chcbaram/wiznet-iot-speaker/software/wiz-iot-gui/README.md

# wiz-iot-gui

## 개요 
- WIZ-IOT-SPEAKER  GUI 프로그램 

## 개발환경
- python3
- PySide6 6.5.0
- scipy

## 설치하기
- 패키지 설치
  ```
  pip install -r requirements.txt

  ```
- 실행하기
  ```
  python wiz-iot-gui.py
  or
  python3 wiz-iot-gui.py
  ```
