chcbaram/wiznet-iot-speaker/hardware/io_bd/BOM_PCB_IOT-SPEAKER-IO_2023-04-30.csv

ID | Name | Designator | Footprint | Quantity | Manufacturer Part | Manufacturer | Supplier | Supplier Part | Price | Pins | 3DModel | Contributor | Resistance (Ohms) | link
1 | 0Ω | R1,R39 | R0402 | 2 | 0402WGF0000TCE | UNI-ROYAL(厚声) | LCSC | C17168 |  | 2 | KNOB-CHROME-20 | lcsc | 0 | https://item.szlcsc.com/323315.html
2 | 240X240 ST7789 TFT SPI DISPLAY | U4 | 240X240 1.3 TFT SPI DISPLAY | 1 |  |  |  |  |  | 7 | User Library-1_3 TFT IPS - Module | bryan_6020 |  | https://www.aliexpress.com/item/1005001511580368.html
3 | 0Ω | R2 | R0402 | 1 | 0402WGF0000TCE | UNI-ROYAL(厚声) | LCSC | C17168 |  | 2 | cube2x2m | lcsc | 0 | https://item.szlcsc.com/323315.html
4 | 0.1u | C1,C2,C3,C4 | C0603 | 4 |  |  |  |  |  | 2 | C0603_L1.6-W0.8-H0.8 | LCEDA_Lib |  | https://item.szlcsc.com/362304.html
5 | 10k | R3,R4,R5,R6,R7,R8 | R0603 | 6 |  |  |  |  |  | 2 | R0603 | LCEDA_Lib |  | https://www.mouser.in/datasheet/2/447/PYu_RT_1_to_0_01_RoHS_L_11-1669912.pdf
6 | ROTARY-ENCODER | U1,U2 | ROTATY-ENCODER | 2 |  |  |  |  |  | 7 | Rotary encoder | sakdnx
7 | FH-00094 | H2 | HDR-TH_30P-P2.54-V-F-R2-C15-S2.54 | 1 | FH-00094 | Liansheng(连盛) | LCSC | C2829904 | 0.043 | 30 | HDR2.54-F-LI-2X15P | LCSC |  | https://item.szlcsc.com/59416.html
