chcbaram/wiznet-iot-speaker/hardware/main_bd/BOM_PCB_IOT-SPEAKER_2023-04-30.csv

ID | Name | Designator | Footprint | Quantity | Manufacturer Part | Manufacturer | Supplier | Supplier Part | Price | Pins | 3DModel | Contributor | Frequency | Resistance | Resistance (Ohms) | link
1 | 100nF | C55,C57,C37,C43,C44,C45,C46,C47,C48,C49,C50,C51,C52,C53,C36,C16,C17,C18,C19,C20,C21,C23,C24,C25,C26,C27,C28,C29,C30,C31,C33,C34,C22,C11,C13 | C0402 | 35 | CL05B104KB54PNC | Samsung Electro-Mechanics | LCSC | C307331 | 0.001 | 2 | C0402_L1.0-W0.5-H0.5 | LCSC |  |  |  | https://item.szlcsc.com/15869.html
2 | 100nF | C56 | C0603 | 1 | C1608X7R104KGTS | DARFON(达方) | LCSC | C335111 |  | 2 | C0603_L1.6-W0.8-H0.8 | LCSC |  |  |  | https://item.szlcsc.com/362304.html
3 | 10kΩ | R45,R46,R41,R15,R36,R37,R7 | R0402 | 7 | 0402WGF1002TCE | UniOhm | LCSC | C25744 |  | 2 | R0402_L1.0-W0.5-H0.5 | lcsc |  |  | 10K | https://item.szlcsc.com/323315.html
4 | 74LVC1G125GW,125 | U8 | SOT-353_L2.1-W1.3-P0.65-LS2.3-BR | 1 | 74LVC1G125GW,125 | Nexperia(安世) | LCSC | C12519 | 0.014 | 5 | SOT-353-5P_L2.0-W1.3-H1.1-LS2.0-P0.65 | lcsc |  |  |  | https://item.szlcsc.com/421835.html
5 | 74LVC1G126GW,125 | U9 | SOT-353_L2.2-W1.4-P0.65-LS2.4-BR | 1 | 74LVC1G126GW,125 | Nexperia(安世) | LCSC | C55052 | 0.012 | 5 | SOT-353-5P_L2.0-W1.3-H1.1-LS2.0-P0.65 | lcsc |  |  |  | https://item.szlcsc.com/330720.html
6 | 2.2uF | C38,C40,C39 | C0402 | 3 | CL05A225MQ5NSNC | SAMSUNG(三星) | LCSC | C12530 |  | 2 | C0402_L1.0-W0.5-H0.5 | lcsc |  |  |  | https://item.szlcsc.com/15869.html
7 | 1uF | C41,C42,C2,C32,C7,C8,C9,C10 | C0402 | 8 | CL05A105KA5NQNC | SAMSUNG | LCSC | C52923 | 0.001 | 2 | C0402_L1.0-W0.5-H0.5 | lcsc |  |  |  | https://item.szlcsc.com/15869.html
8 | 0Ω | R39,R40,R26,R27 | R0402 | 4 | 0402WGF0000TCE | UNI-ROYAL(厚声) | LCSC | C17168 |  | 2 | R0402_L1.0-W0.5-H0.5 | lcsc |  |  | 0 | https://item.szlcsc.com/323315.html
9 | S3B-EH(LF)(SN) | CN1 | CONN-TH_3P-P2.50_S3B-EH-LF-SN | 1 | S3B-EH(LF)(SN) | JST Sales America | LCSC | C263754 | 0.008 | 3 | CONN-TH_3P-P2.50_S3B-EH-LF-SN | LCSC |  |  |  | https://lcsc.com/product-detail/Wire-To-Board-Wire-To-Wire-Connector_JST-Sales-America_S3B-EH-LF-SN_JST-Sales-America-S3B-EH-LF-SN_C263754.html
10 | 10uF | C35,C5 | C1206 | 2 | CL31A106KBHNNNE | SAMSUNG | LCSC | C13585 | 0.005 | 2 | C1206_L3.2-W1.6-H1.3 | lcsc |  |  |  | https://item.szlcsc.com/89171.html
11 | NSR0320MW2T1G | D2,D3 | SOD-323_L1.8-W1.3-LS2.5-RD | 2 | NSR0320MW2T1G | ON | LCSC | C48192 | 0.01 | 2 | SOD-323_L1.7-W1.3-H1.1-LS2.5 | lcsc |  |  |  | https://item.szlcsc.com/295156.html
12 | 100K | R12 | R0402 | 1 | AC0402JR-07100KL | YAGEO | LCSC | C144732 |  | 2 | R0402_L1.0-W0.5-H0.5 | LCSC |  | 100kΩ |  | https://item.szlcsc.com/323315.html
13 | XC6210B332MR_C424705 | U3 | SOT-25_L3.0-W1.6-P0.95-LS2.8-BL | 1 | XC6210B332MR | Torex Semicon | LCSC | C424705 | 0.054 | 5 | SOT-25-5_L3.0-W1.6-H1.3-LS2.8-P0.95 | LCSC |  |  |  | https://item.szlcsc.com/464949.html
14 | 5.1kΩ | R31,R32,R14,R23,R25,R1,R2 | R0402 | 7 | 0402WGF5101TCE | UniOhm | LCSC | C25905 |  | 2 | R0402_L1.0-W0.5-H0.5 | lcsc |  |  | 5.1K | https://item.szlcsc.com/323315.html
15 | 53261-0471 | CN4,CN5 | CONN-SMD_4P-P1.25_53261-0471 | 2 | 53261-0471 | MOLEX | LCSC | C240847 | 0.02 | 6 | CONN-SMD_MX1.25-WS-4P | LCSC |  |  |  | https://list.szlcsc.com/catalog/11068.html
16 | 1N5819WS | D4 | SOD-323_L1.8-W1.3-LS2.5-RD | 1 | 1N5819WS | Hottech(合科泰) | LCSC | C191023 | 0.002 | 2 | SOD-323_L1.7-W1.3-H1.1-LS2.5 | LCSC |  |  |  | https://item.szlcsc.com/295156.html
17 | MMBT2222A_C8512 | Q1 | SOT-23-3_L2.9-W1.3-P1.90-LS2.4-BR | 1 | MMBT2222A 1P | CJ(江苏长电/长晶) | LCSC | C8512 | 0.003 | 3 | SOT-23-3P_L2.9-W1.3-H1.0-LS2.4-P0.95 | lcsc |  |  |  | https://www.diodes.com/assets/Package-Files/SOT23.pdf
18 | 1kΩ | R33 | R0402 | 1 | 0402WGF1001TCE | UniOhm | LCSC | C11702 |  | 2 | R0402_L1.0-W0.5-H0.5 | lcsc |  |  | 1K | https://item.szlcsc.com/323315.html
19 | 470Ω | R34,R35,R38 | R0402 | 3 | 0402WGF4700TCE | UniOhm | LCSC | C25117 |  | 2 | R0402_L1.0-W0.5-H0.5 | lcsc |  |  | 470 | https://item.szlcsc.com/323315.html
20 | Y2C-CQ2R2L-YELLOW | LED5,LED1,LED6,LED7,LED8,LED3 | LED0603-RD-YELLOW | 6 | 19-213/Y2C-CQ2R2L/3T(CY) | EVERLIGHT(亿光) | LCSC | C72038 | 0.004 | 2 | LED0603-RD-YELLOW | lcsc |  |  |  | https://atta.szlcsc.com/upload/public/pdf/source/20180129/C125100_15171877314981315871.pdf
21 | 1MΩ | R3 | R0603 | 1 | 0603WAF1004T5E | UNI-ROYAL(厚声) | LCSC | C22935 |  | 2 | R0603 | lcsc |  |  | 1M | https://www.mouser.in/datasheet/2/447/PYu_RT_1_to_0_01_RoHS_L_11-1669912.pdf
22 | FST-5030 | BUZZER1 | BUZ-SMD_FST-5030 | 1 | FUET-5030 | FUET(福声科技) | LCSC | C391031 | 0.1 | 3 | BUZ-SMD_3P-L5.0-W5.0-H3.0-P3.50 | LCSC | 4kHz |  |  | https://item.szlcsc.com/367493.html
23 | PZ254-2-15-Z-8.5 | H1 | HDR-TH_30P-P2.54-V-M-R2-C15-S2.54 | 1 | PZ254-2-15-Z-8.5 | HCTL(华灿天禄) | LCSC | C2894976 | 0.052 | 30 | HDR-TH_30P-P2.54-M-LI-2X15P | LCSC |  |  |  | https://item.szlcsc.com/57525.html
24 | 533980371 | J1 | CONN-SMD_3P-P1.25_53398-0371 | 1 | 533980371 | MOLEX | LCSC | C293633 | 0.018 | 5 | CONN-SMD_MX1.25-LS-3P | LCSC |  |  |  | https://item.szlcsc.com/278549.html
25 | 0533980271 | CN6 | CONN-SMD_2P-P1.25_053398-0X71 | 1 | 0533980271 | MOLEX | LCSC | C122410 | 0.017 | 4 | CONN-SMD_MX1.25-LS-2P | 立创EDA官方封装库 |  |  |  | https://atta.szlcsc.com/upload/public/pdf/source/20170721/C122410_1500619309943834053.pdf
26 | 533980471 | CN9 | CONN-SMD_4P-P1.25_533980471 | 1 | 533980471 | MOLEX | LCSC | C234195 | 0.02 | 6 | CONN-SMD_MX1.25-LS-4P | LCSC |  |  |  | https://item.szlcsc.com/233965.html
27 | RT7-ZZ-0117 | RJ1 | RJ45-TH_RT7-ZZ-0117 | 1 | RT7-ZZ-0117 | UDE Corp | LCSC | C711503 | 0.287 | 14 | RJ45-TH_RT7-ZZ-0117 | LCSC |  |  |  | https://item.szlcsc.com/750222.html
28 | 10uF | C1,C6 | CAP-SMD_L3.2-W1.6-RD-C7171 | 2 | TAJA106K016RNJ | Kyocera AVX | LCSC | C7171 | 0.014 | 2 | CASE-A_L3.2-W1.6-H1.6 | lcsc |  |  |  | https://item.szlcsc.com/210648.html
29 | 1nF | C15 | C1206 | 1 | 1206B102K202NT | FH(风华) | LCSC | C9196 | 0.001 | 2 | C1206_L3.2-W1.6-H1.3 | lcsc |  |  |  | https://item.szlcsc.com/89171.html
30 | 330Ω | R16,R17,R18,R19,R20,R21,R22 | R0402 | 7 | 0402WGF3300TCE | UNI-ROYAL(厚声) | LCSC | C25104 |  | 2 | R0402_L1.0-W0.5-H0.5 | lcsc |  |  | 330 | https://item.szlcsc.com/323315.html
31 | 49.9Ω | R24,R28,R29,R30 | R0402 | 4 | 0402WGF499JTCE | UNI-ROYAL(厚声) | LCSC | C25120 |  | 2 | R0402_L1.0-W0.5-H0.5 | lcsc |  |  | 49.9 | https://item.szlcsc.com/323315.html
32 | 1SS181 | D1 | SOT-23-3_L2.9-W1.6-P1.90-LS2.8-BR-CW | 1 | 1SS181 | CJ(江苏长电/长晶) | LCSC | C8550 | 0.004 | 3 | SOT-23-3L_L2.9-W1.6-H1.1-LS2.8-P0.95 | lcsc |  |  |  | https://item.szlcsc.com/14454.html
33 | GHC-YR1S2-EMERALD | LED2 | LED0603-RD | 1 | 19-217/GHC-YR1S2/3T | EVERLIGHT(亿光) | LCSC | C72043 | 0.004 | 2 | LED0603-RD | lcsc |  |  |  | https://item.szlcsc.com/347874.html
34 | XL-1608SURC-RED | LED4 | LED0603-RD_RED | 1 | XL-1608SURC-06 | XINGLIGHT(成兴光) | LCSC | C965799 | 0.001 | 2 | LED0603-RD_RED | LCSC |  |  |  | https://item.szlcsc.com/221679.html
35 | 100kΩ | R4,R5,R6,R8 | R0402 | 4 | 0402WGF1003TCE | UNI-ROYAL(厚声) | LCSC | C25741 |  | 2 | R0402_L1.0-W0.5-H0.5 | lcsc |  |  | 100K | https://item.szlcsc.com/323315.html
36 | 12kΩ 1% | R9 | R0402 | 1 | 0402WGF1202TCE | UNI-ROYAL(厚声) | LCSC | C25752 |  | 2 | R0402_L1.0-W0.5-H0.5 | lcsc |  |  | 12K | https://item.szlcsc.com/323315.html
37 | 300Ω 1% | R10 | R0402 | 1 | 0402WGF3000TCE | UNI-ROYAL(厚声) | LCSC | C25102 |  | 2 | R0402_L1.0-W0.5-H0.5 | lcsc |  |  | 300 | https://item.szlcsc.com/323315.html
38 | TYPE-C 6P(073) | USB3 | TYPE-C-SMD_TYPE-C-6P | 1 | TYPE-C 6P(073) | SHOU HAN(首韩) | LCSC | C668623 | 0.006 | 10 | TYPE-C-SMD_6P-L8.9-W6.8-H3.2-P1.00 | LCSC |  |  |  | https://item.szlcsc.com/458819.html
39 | 6.8pF | C12,C14 | C0402 | 2 | 0402CG6R8C500NT | FH(风华) | LCSC | C1576 |  | 2 | C0402_L1.0-W0.5-H0.5 | lcsc |  |  |  | https://item.szlcsc.com/15869.html
40 | 10pF | C3,C4 | C0402 | 2 | CL05C100JB5NNNC | SAMSUNG(三星) | LCSC | C32949 | 0.001 | 2 | C0402_L1.0-W0.5-H0.5 | lcsc |  |  |  | https://item.szlcsc.com/15869.html
41 | 25MHz | X2 | OSC-SMD_4P-L3.2-W2.5-BL | 1 | OT322525MJBA4SL | YXC(扬兴晶振) | LCSC | C669088 | 0.074 | 4 | OSC-SMD_4P-L3.2-W2.5-H1.0 | LCSC |  |  |  | https://item.szlcsc.com/15866.html
42 | W5300 | U1 | LQFP-100_L14.0-W14.0-P0.50-LS16.0-BL | 1 | W5300 | WIZNET | LCSC | C41156 | 1.405 | 100 | LQFP-100_L14.0-W14.0-H1.4-LS16.0-P0.50 | lcsc |  |  |  | https://item.szlcsc.com/417273.html
43 | STM32H723ZGT6 | U2 | LQFP-144_L20.0-W20.0-P0.50-LS22.0-BL | 1 | STM32H723ZGT6 | ST(意法半导体) | LCSC | C730146 | 1.813 | 144 | LQFP-144_L20.0-W20.0-P0.50-LS22.0-BL | LCSC |  |  |  | https://item.szlcsc.com/185665.html
44 | KH-TYPE-C-16P-T | USB1 | USB-C-SMD_KH-TYPE-C-16P | 1 | KH-TYPE-C-16P-T | Shenzhen Kinghelm Elec | LCSC | C709358 | 0.017 | 20 | USB-C_SMD-TYPE-C-31-M-12 | LCSC |  |  |  | https://item.szlcsc.com/747093.html
45 | TF-015 | CARD2 | TF-SMD_TF-015 | 1 | TF-015 | SOFNG | LCSC | C113206 | 0.031 | 13 | TF-SMD_L14.8-W14.5-H1.9-P1.1 | 立创EDA官方封装库 |  |  |  | https://atta.szlcsc.com/upload/public/pdf/source/20201230/C410351_87BE98C0247012AA7FFCC5A0490FF8D3.pdf
46 | IDC_DC3-14P 2X7P双排直针插座 | CN3 | IDC-TH_14P-P1.27_C9900022506 | 1 | IDC_DC3-14P 2X7P双排直针插座 | null | LCSC | C9900022506 |  | 14 | IDC-TH_14P-P1.27_C9900022506 | lcsc |  |  |  | https://img.jlc.com/pdf/applyPasteComponent/2022-06-24/582943A/d1dec1e882ce4563bda310dbdf5641bd/IDC3-14P%E5%8F%8C%E6%8E%92%E7%9B%B4%E9%92%88%E6%8F%92%E5%BA%A7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
47 | NC | R11 | R0603 | 1 | R0603RXX104XJ10LTS | Shenzhen Eyang Tech Development | LCSC |  |  | 2 | R0603_L1.6-W0.8-H0.8 | LCSC |  |  | NC | https://www.mouser.in/datasheet/2/447/PYu_RT_1_to_0_01_RoHS_L_11-1669912.pdf
48 | MAX98357AETE+T | U5 | TQFN-16_L3.0-W3.0-P0.50-BL-EP1.5 | 1 | MAX98357AETE+T | MAXIM(美信) | LCSC | C910544 | 0.136 | 17 | TQFN-16_L3.0-W3.0-P0.50-BL-EP1.5 | LCSC |  |  |  | https://item.szlcsc.com/533528.html
49 | PJ-327C-4A | AUDIO1 | AUDIO-SMD_PJ-327C-4A | 1 | PJ-327C-4A | HRO | LCSC | C145813 | 0.019 | 4 | AUDIO-SMD_L11.8-W6.0-H5.0-4P | LCSC |  |  |  | https://item.szlcsc.com/157145.html
50 | ES8156 | U6 | QFN-20_L3.0-W3.0-P0.40-TL-EP1.7 | 1 | ES8156 | Everest-semi(顺芯) | LCSC | C2887138 | 0.086 | 21 | QFN-20_L3.0-W3.0-H0.6-P0.40-BL | LCSC |  |  |  | https://img.jlc.com//pdf/applyPasteComponent/2021-08-16/1325578A/829bd16b0cc1491bbaa694c3e8fa849f/ES8156.PDF
51 | SKRPACE010 | SW1,SW2,SW3,SW4,SW5 | KEY-SMD_4P-L4.2-W3.2-P2.20-LS4.6 | 5 | SKRPACE010 | ALPS | LCSC | C139797 | 0.007 | 4 | KEY-SMD_4P-L4.2-W3.2-H2.5-LS4.6-P2.2 | LCSC |  |  |  | https://item.szlcsc.com/157210.html
52 | 25MHz | X1 | CRYSTAL-SMD_4P-L3.2-W2.5-BL | 1 | X322525MMB4SI | YXC(扬兴晶振) | LCSC | C70582 | 0.014 | 4 | OSC-SMD_4P-L3.2-W2.5-H1.0 | lcsc |  |  |  | https://item.szlcsc.com/15866.html
53 | 32.768kHz | X3 | OSC-SMD_L3.2-W1.5 | 1 | X1A000141000600 | EPSON(爱普生) | LCSC | C94673 | 0.053 | 2 | OSC-SMD_L3.2-W1.5-H0.8 | lcsc |  |  |  | https://item.szlcsc.com/100222.html
54 | W25Q128JVSIQTR | U7 | SOIC-8_L5.3-W5.3-P1.27-LS8.0-BL | 1 | W25Q128JVSIQTR | WINBOND | LCSC | C97521 | 0.112 | 8 | SOIC-8_L5.3-W5.3-H1.9-LS7.9-P1.27 | lcsc |  |  |  | https://item.szlcsc.com/63461.html
