chcbaram/wiznet-iot-speaker/hardware/io_bd/Schematic_IOT-SPEAKER-IO_2023-04-30.pdf

## 1.3" IPS 240x240 SPI

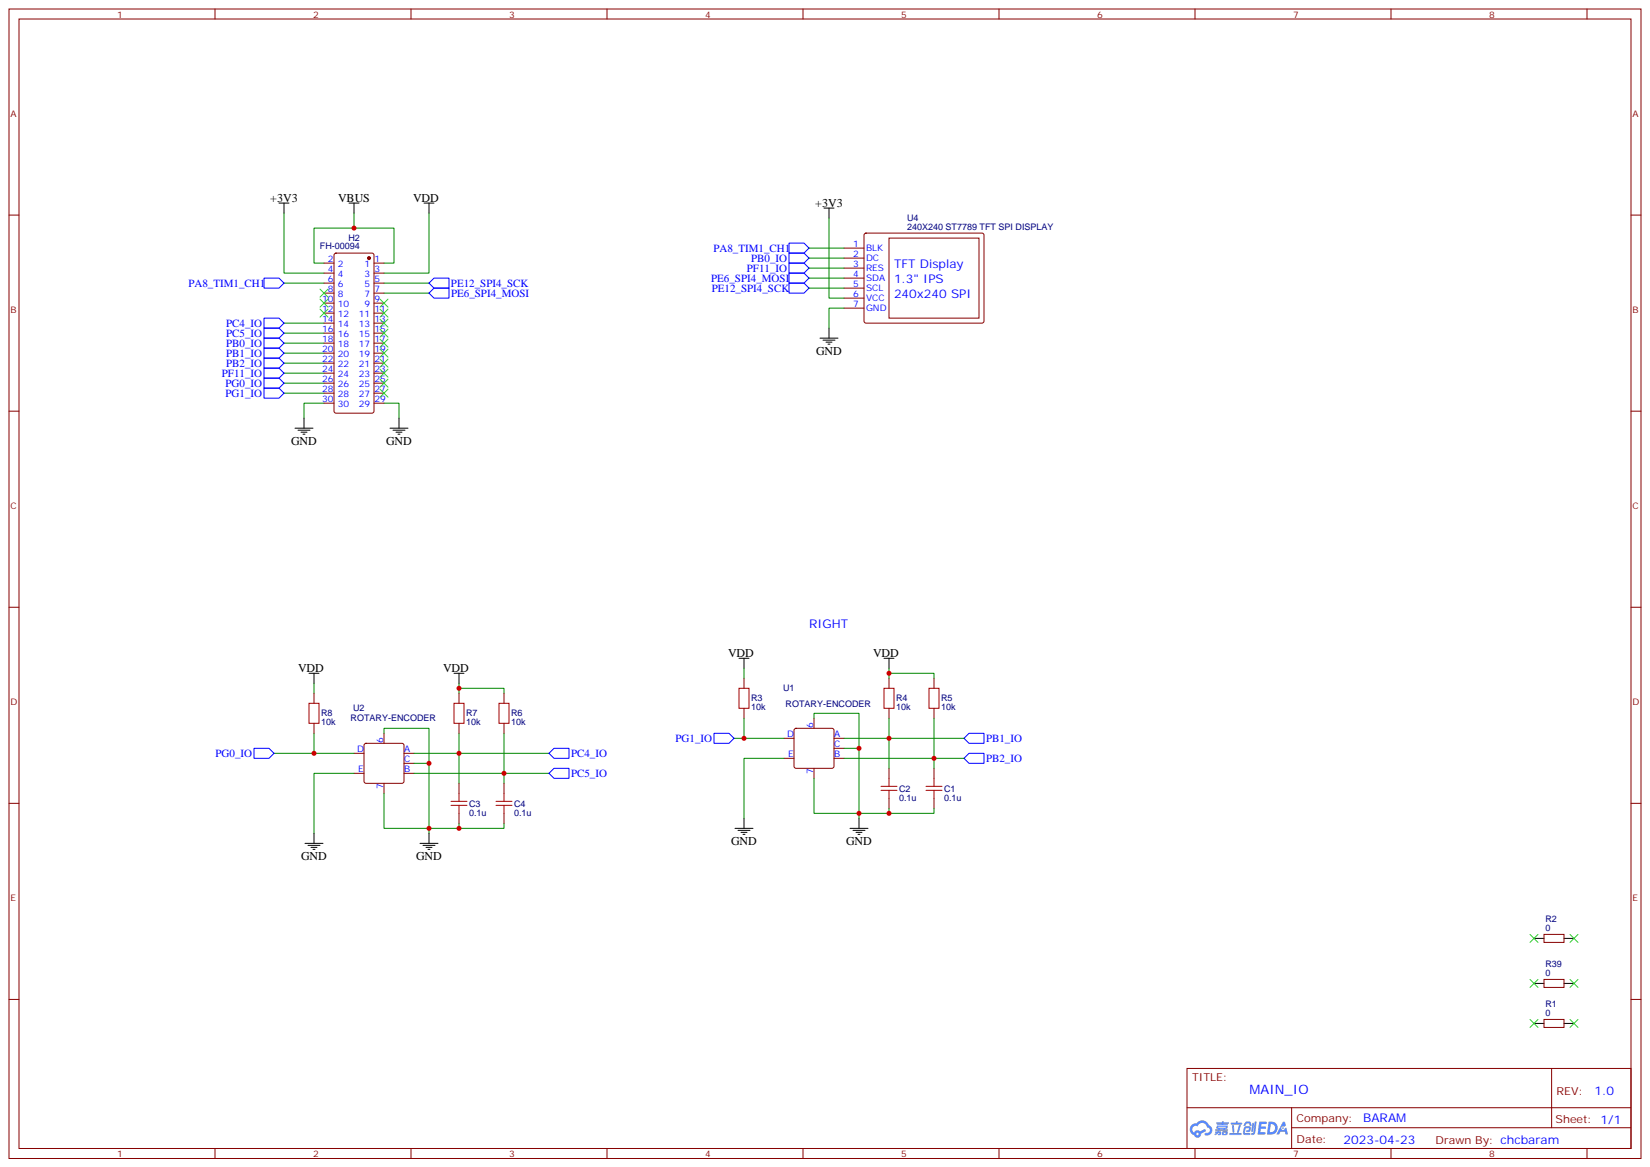
[picture p1: page 1]
