chcbaram/wiznet-iot-speaker/hardware/main_bd/Schematic_IOT-SPEAKER_2023-04-30.pdf

VDD 72 PB12 73 PB13 74 PB14 75 PB15 76 PD8 77 PD9 78 PD10 79 PD11 80 PD12 81 PD13 82 VSS 83 VDD 84 PD14 85 PD15 86 PG2 87 PG3 88 PG4 89 PG5 90 PG6 91 PG7 92 PG8 93 VSS 94 VDD33USB 95 PC6 96 PC7 97 PC8 98 PC9 99 PA8 100 PA9 101 PA10 102 PA11 103 PA12 104 PA13 105 VCAP 106 VSS 107 VDD 108 PA14 109 PA15 110 PC10 111 PC11 112 PC12 113 PD0 114 PD1 115 PD2 116 PD3 117 PD4 118 PD5 119 VSS 120 VDD 121 PD6 122 PD7 123 PG9 124 PG10 125 PG11 126 PG12 127 PG13 128 PG14 129 VSS 130 VDD 131 PG15 132 PB3 133 PB4 134 PB5 135 PB6 136 PB7 137 BOOT0 138 PB8 139 PB9 140 PE0 141 PE1 142 PDR_ON 143 VDD 144

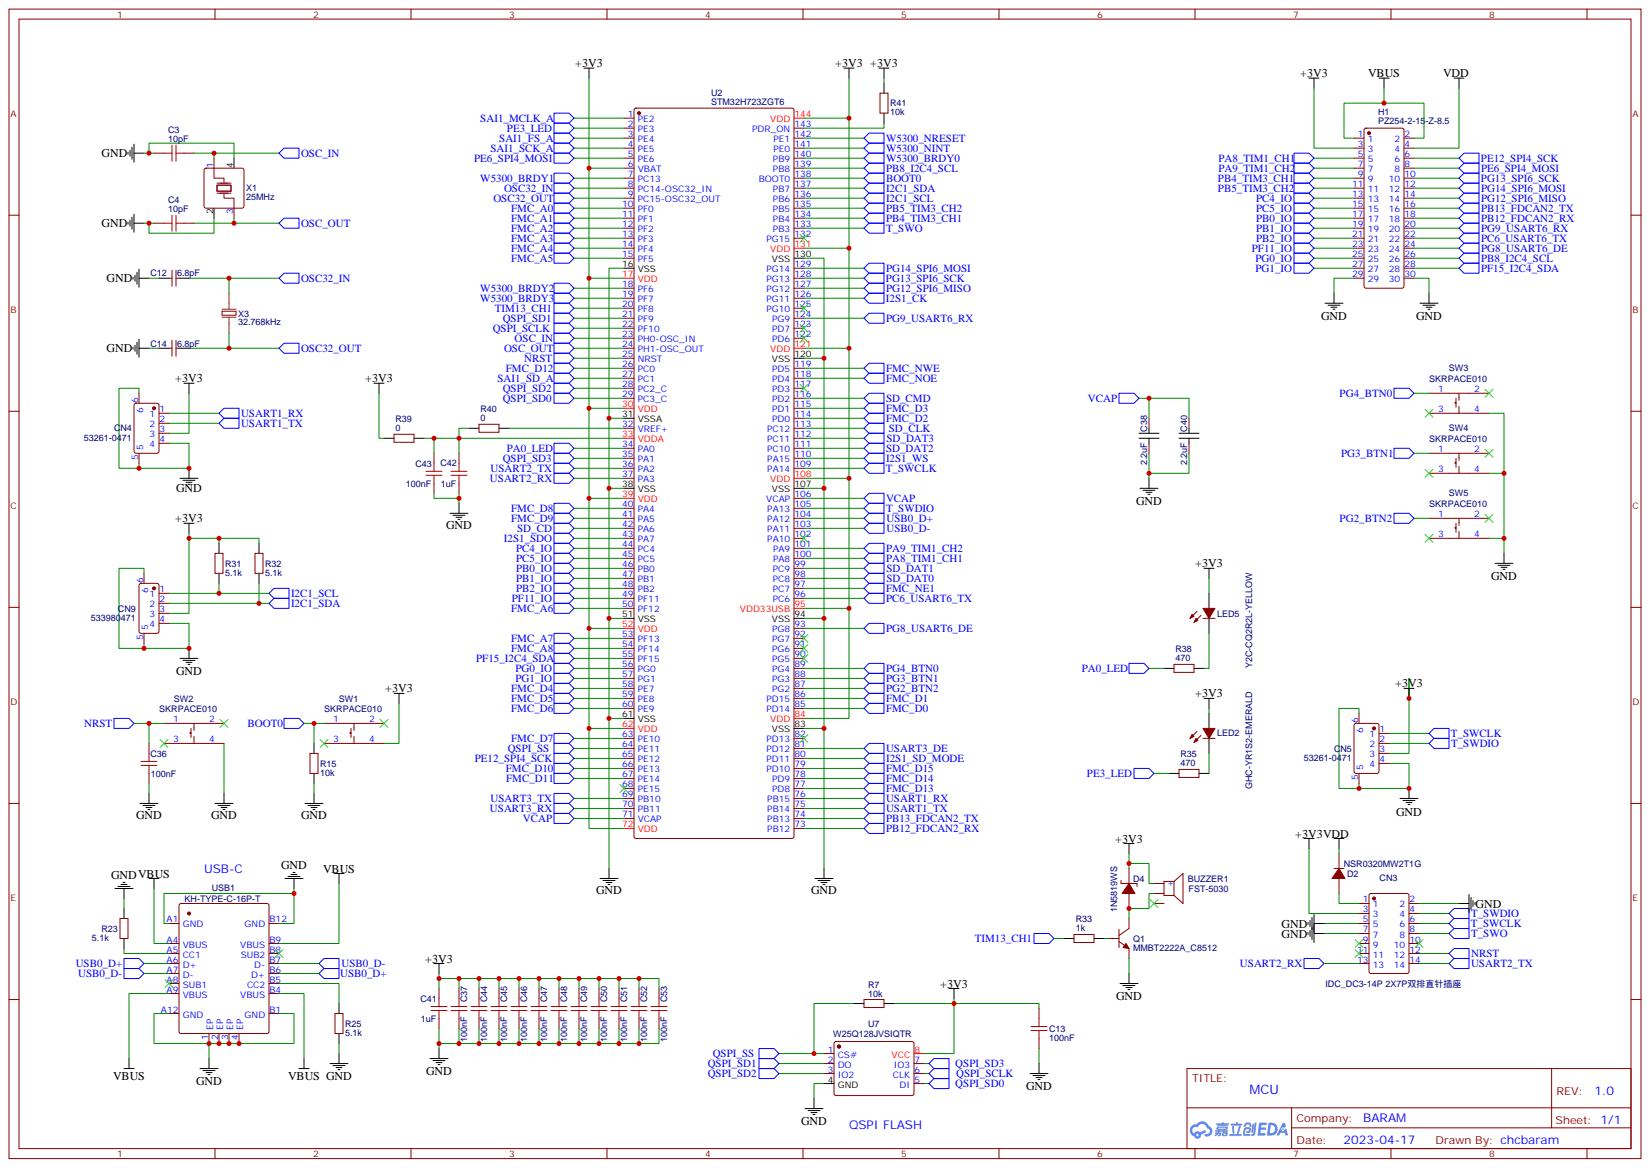
[picture p2: page 1]

ADDR6 51 ADDR5 52 ADDR4 53 ADDR3 54 ADDR2 55 ADDR1 56 ADDR0 57 VCC1V8 58 GND 59 /WR 60 /RD 61 /CS 62 VCC3V3 63 GND 64 /INT 65 /RESET 66 BRDY0 67 BRDY1 68 BRDY2 69 BRDY3 70 MII_RXC 71 VCC1V8 72 GND 73 MII_RXDV 74 MII_RXD0 MII_RXD¹

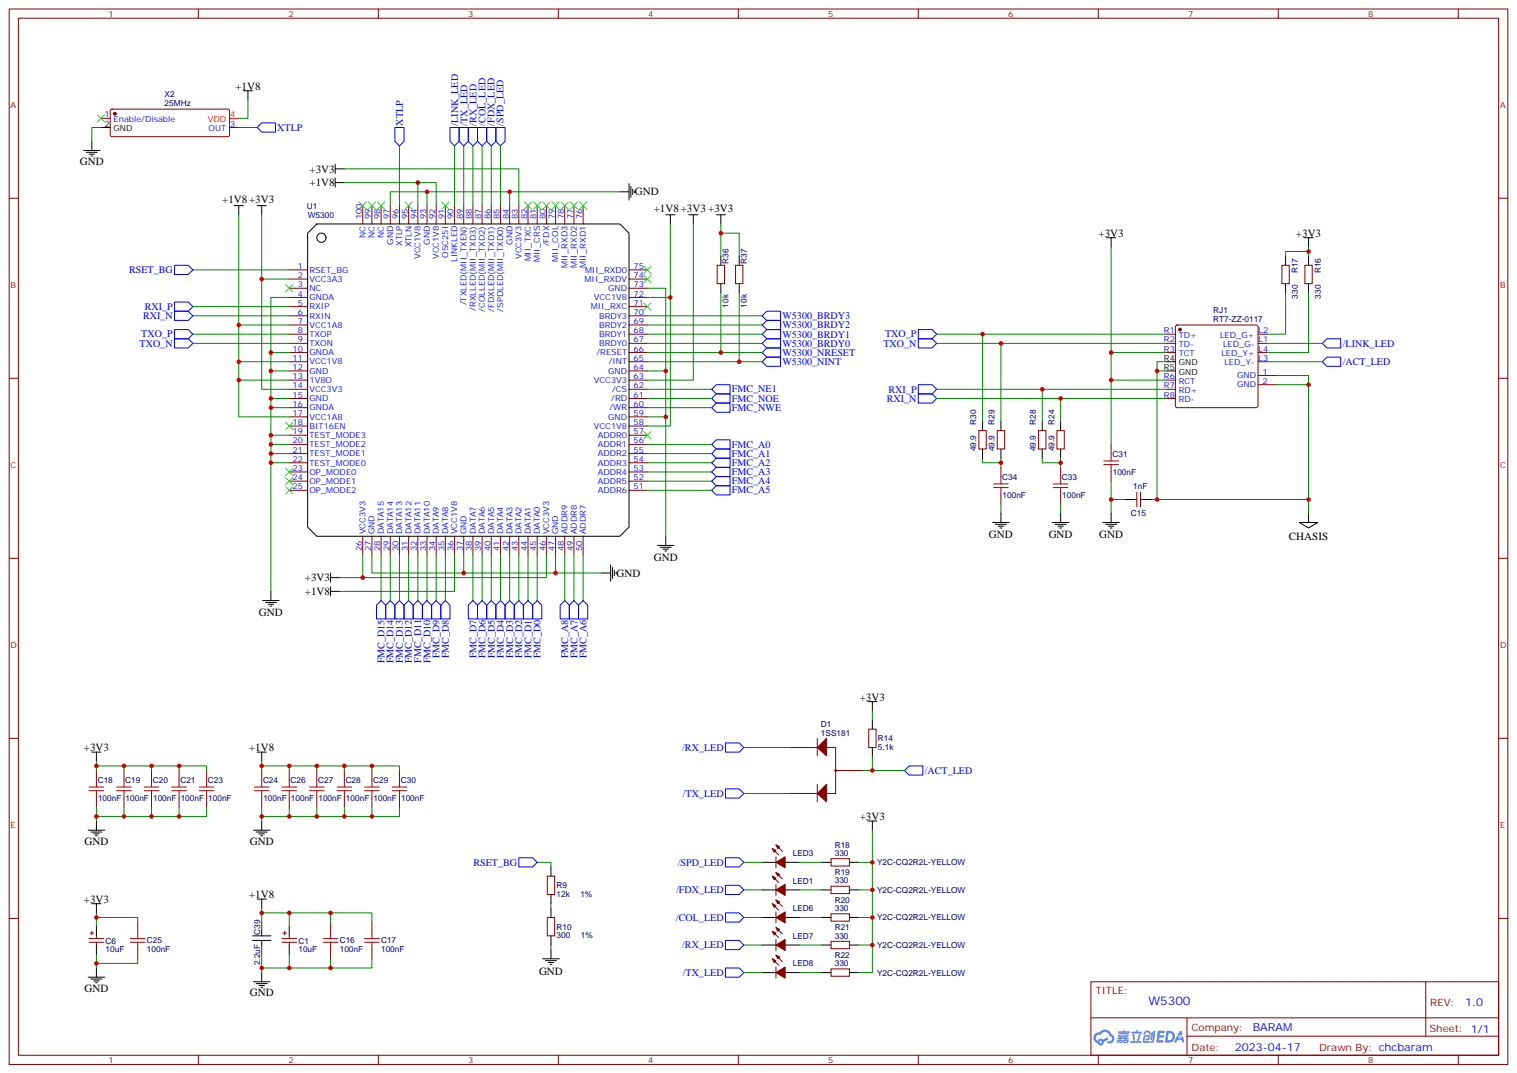
[picture p3: page 2]

76 MII_RXD2 77 MII_RXD3 78 MII_COL 79 /FDX 80 MII_CRS 81 MII_TXC 82 VCC3V3 83 GND 84 /SPDLED(MII_TXD0) 85 /FDXLED(MII_TXD1) 86 /COLLED(MII_TXD2) 87 /RXLLED(MII_TXD3) 88 /TXLED(MII_TXEN) 89 LINKLED 90 OSC25I 91 VCC1V8 92 GND 93 VCC1V8 94 XTLN 95 XTLP 96 GND 97 NC 98 NC 99 NC 100

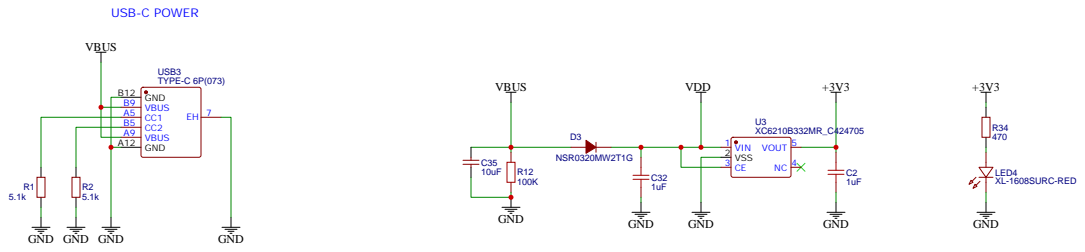
[picture p4: page 3]

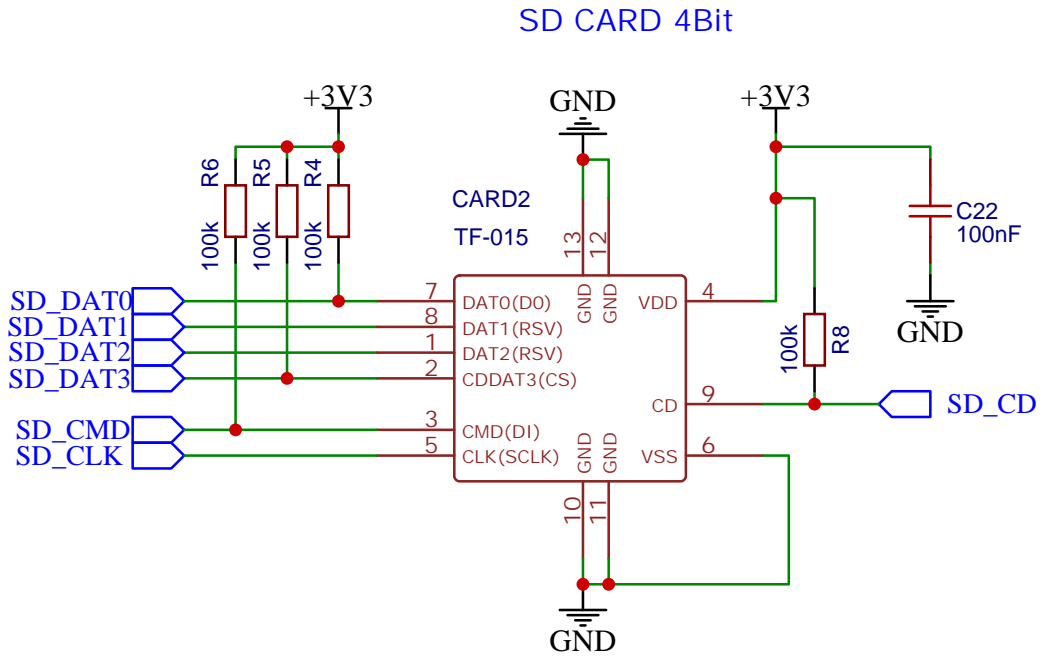
[picture p5: page 4]

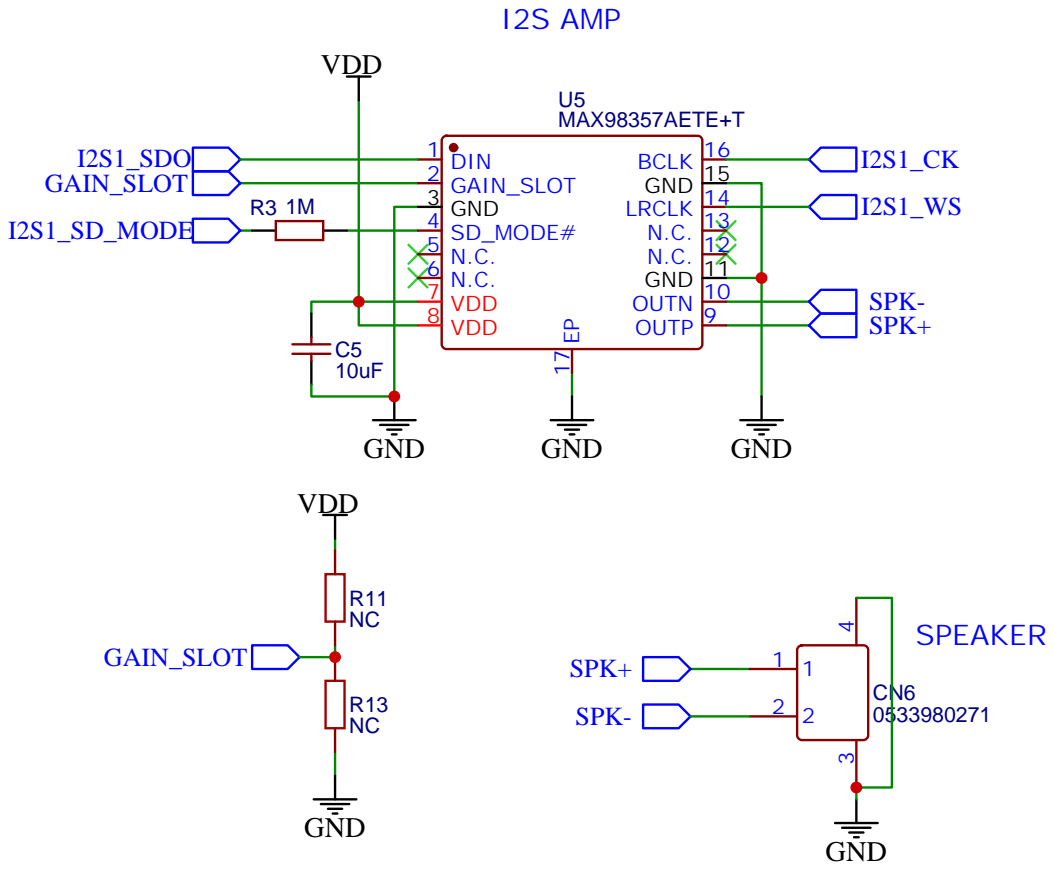
[picture p6: page 5]

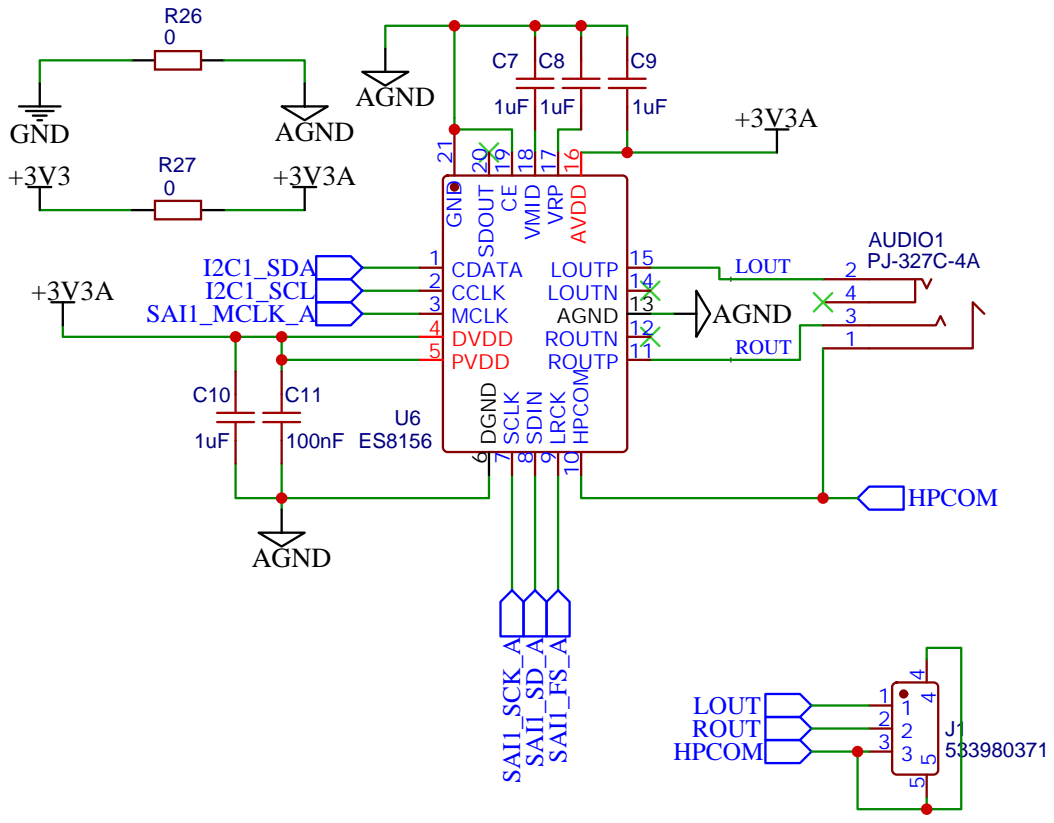
[picture p7: page 6]

ROUTP 11 ROUTN 12 AGND 13 LOUTN 14 LOUTP 15 AVDD ¹⁶ VRP 17

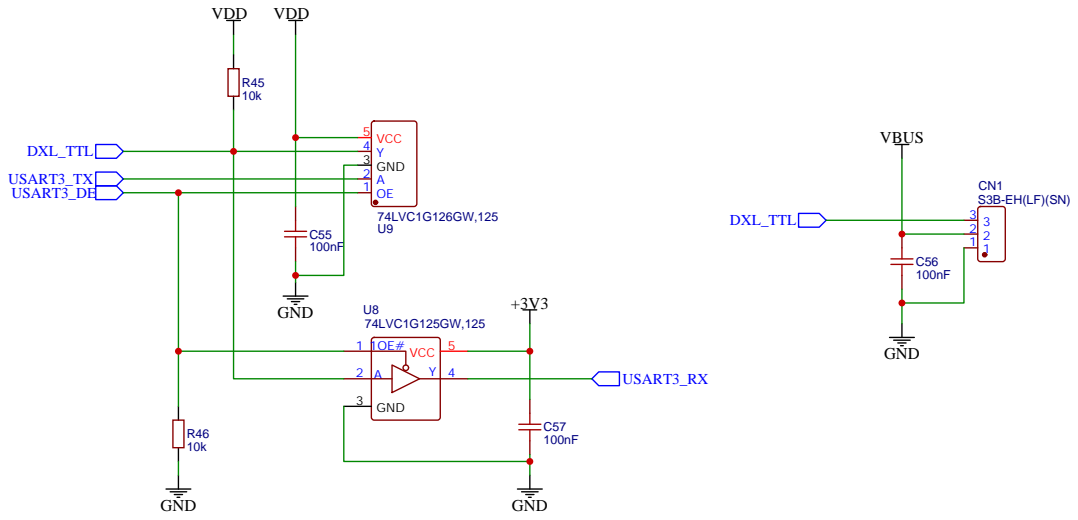
[picture p8: page 7]
