chcbaram/wiznet-iot-speaker/firmware/stm32cube/Core/Inc/main.h

#define LED_Pin GPIO_PIN_3
#define LED_GPIO_Port GPIOE
#define W5300_BRDY1_Pin GPIO_PIN_13
#define W5300_BRDY1_GPIO_Port GPIOC
#define W5300_BRDY2_Pin GPIO_PIN_6
#define W5300_BRDY2_GPIO_Port GPIOF
#define W5300_BRDY3_Pin GPIO_PIN_7
#define W5300_BRDY3_GPIO_Port GPIOF
#define PA0_LED_Pin GPIO_PIN_0
#define PA0_LED_GPIO_Port GPIOA
#define SD_CD_Pin GPIO_PIN_6
#define SD_CD_GPIO_Port GPIOA
#define PC4_IO_Pin GPIO_PIN_4
#define PC4_IO_GPIO_Port GPIOC
#define PC5_IO_Pin GPIO_PIN_5
#define PC5_IO_GPIO_Port GPIOC
#define PB0_IO_Pin GPIO_PIN_0
#define PB0_IO_GPIO_Port GPIOB
#define PB1_IO_Pin GPIO_PIN_1
#define PB1_IO_GPIO_Port GPIOB
#define PB2_IO_Pin GPIO_PIN_2
#define PB2_IO_GPIO_Port GPIOB
#define PF11_IO_Pin GPIO_PIN_11
#define PF11_IO_GPIO_Port GPIOF
#define PG0_IO_Pin GPIO_PIN_0
#define PG0_IO_GPIO_Port GPIOG
#define PG1_IO_Pin GPIO_PIN_1
#define PG1_IO_GPIO_Port GPIOG
#define I2S1_SD_MODE_Pin GPIO_PIN_11
#define I2S1_SD_MODE_GPIO_Port GPIOD
#define PG2_BTN2_Pin GPIO_PIN_2
#define PG2_BTN2_GPIO_Port GPIOG
#define PG3_BTN1_Pin GPIO_PIN_3
#define PG3_BTN1_GPIO_Port GPIOG
#define PG4_BTN0_Pin GPIO_PIN_4
#define PG4_BTN0_GPIO_Port GPIOG
#define W5300_BRDY0_Pin GPIO_PIN_9
#define W5300_BRDY0_GPIO_Port GPIOB
#define W530_NINT_Pin GPIO_PIN_0
#define W530_NINT_GPIO_Port GPIOE
#define W530_NRES_Pin GPIO_PIN_1
#define W530_NRES_GPIO_Port GPIOE
