chcbaram/wiznet-iot-speaker/firmware/wiznet-iot-speaker-boot/src/hw/driver/uart.c

#include "uart.h"
#include "qbuffer.h"
#include "cli.h"
#include "cdc.h"

#ifdef _USE_HW_UART


#define UART_RX_BUF_LENGTH        1024



typedef struct
{
  bool is_open;
  uint32_t baud;

  uint8_t  rx_buf[UART_RX_BUF_LENGTH];
  qbuffer_t qbuffer;
  UART_HandleTypeDef *p_huart;
  DMA_HandleTypeDef  *p_hdma_rx;

  uint32_t rx_cnt;
  uint32_t tx_cnt;
} uart_tbl_t;

typedef struct
{
  const char         *p_msg;
  USART_TypeDef      *p_uart;
  UART_HandleTypeDef *p_huart;
  DMA_HandleTypeDef  *p_hdma_rx;
  DMA_HandleTypeDef  *p_hdma_tx;
  bool                is_rs485;
} uart_hw_t;



#ifdef _USE_HW_CLI
static void cliUart(cli_args_t *args);
#endif


static bool is_init = false;
static uart_tbl_t uart_tbl[UART_MAX_CH];

static UART_HandleTypeDef huart1;
static UART_HandleTypeDef huart2;
static UART_HandleTypeDef huart3;
static DMA_HandleTypeDef hdma_usart1_rx;
static DMA_HandleTypeDef hdma_usart2_rx;
static DMA_HandleTypeDef hdma_usart3_rx;

const static uart_hw_t uart_hw_tbl[UART_MAX_CH] = 
  {
    {"USART2 SWD   ", USART2, &huart2, &hdma_usart2_rx, NULL, false},
    {"USART1 DEBUG ", USART1, &huart1, &hdma_usart1_rx, NULL, false},
    {"USART3 TTL   ", USART3, &huart3, &hdma_usart3_rx, NULL, true},
    {"USB    USB   ", NULL, NULL, NULL, NULL, true},   
  };





bool uartInit(void)
{
  for (int i=0; i<UART_MAX_CH; i++)
  {
    uart_tbl[i].is_open = false;
    uart_tbl[i].baud = 57600;
    uart_tbl[i].rx_cnt = 0;
    uart_tbl[i].tx_cnt = 0;    
  }

  is_init = true;

#ifdef _USE_HW_CLI
  cliAdd("uart", cliUart);
#endif
  return true;
}

bool uartDeInit(void)
{
  return true;
}

bool uartIsInit(void)
{
  return is_init;
}

bool uartOpen(uint8_t ch, uint32_t baud)
{
  bool ret = false;
  HAL_StatusTypeDef ret_hal;


  if (ch >= UART_MAX_CH) return false;

  if (uart_tbl[ch].is_open == true && uart_tbl[ch].baud == baud)
  {
    return true;
  }


  switch(ch)
  {
    case _DEF_UART1:
    case _DEF_UART2:
    case _DEF_UART3:
      uart_tbl[ch].baud      = baud;

      uart_tbl[ch].p_huart   = uart_hw_tbl[ch].p_huart;
      uart_tbl[ch].p_hdma_rx = uart_hw_tbl[ch].p_hdma_rx;
      uart_tbl[ch].p_huart->Instance = uart_hw_tbl[ch].p_uart;    

      uart_tbl[ch].p_huart->Init.BaudRate       = baud;
      uart_tbl[ch].p_huart->Init.WordLength     = UART_WORDLENGTH_8B;
      uart_tbl[ch].p_huart->Init.StopBits       = UART_STOPBITS_1;
      uart_tbl[ch].p_huart->Init.Parity         = UART_PARITY_NONE;
      uart_tbl[ch].p_huart->Init.Mode           = UART_MODE_TX_RX;
      uart_tbl[ch].p_huart->Init.HwFlowCtl      = UART_HWCONTROL_NONE;
      uart_tbl[ch].p_huart->Init.OverSampling   = UART_OVERSAMPLING_16;
      uart_tbl[ch].p_huart->Init.OneBitSampling = UART_ONE_BIT_SAMPLE_DISABLE;
      uart_tbl[ch].p_huart->Init.ClockPrescaler = UART_PRESCALER_DIV1;
      uart_tbl[ch].p_huart->AdvancedInit.AdvFeatureInit = UART_ADVFEATURE_NO_INIT;


      qbufferCreate(&uart_tbl[ch].qbuffer, &uart_tbl[ch].rx_buf[0], UART_RX_BUF_LENGTH);


      __HAL_RCC_DMA1_CLK_ENABLE();

      HAL_UART_DeInit(uart_tbl[ch].p_huart);

      if (uart_hw_tbl[ch].is_rs485 == true)
      {
        ret_hal = HAL_RS485Ex_Init(uart_tbl[ch].p_huart, UART_DE_POLARITY_HIGH, 0, 0);
      }
      else
      {
        ret_hal = HAL_UART_Init(uart_tbl[ch].p_huart);
      }

      if (ret_hal == HAL_OK)
      {
        ret = true;
        uart_tbl[ch].is_open = true;

        if(HAL_UART_Receive_DMA(uart_tbl[ch].p_huart, (uint8_t *)&uart_tbl[ch].rx_buf[0], UART_RX_BUF_LENGTH) != HAL_OK)
        {
          ret = false;
        }

        uart_tbl[ch].qbuffer.in  = uart_tbl[ch].qbuffer.len - ((DMA_Stream_TypeDef *)uart_tbl[ch].p_huart->hdmarx->Instance)->NDTR;
        uart_tbl[ch].qbuffer.out = uart_tbl[ch].qbuffer.in;
      }
      break;

    case _DEF_UART4:
      uart_tbl[ch].baud    = baud;
      uart_tbl[ch].is_open = true;
      ret = true;
      break;      
  }

  return ret;
}

bool uartClose(uint8_t ch)
{
  if (ch >= UART_MAX_CH) return false;

  uart_tbl[ch].is_open = false;

  return true;
}

uint32_t uartAvailable(uint8_t ch)
{
  uint32_t ret = 0;


  switch(ch)
  {
    case _DEF_UART1:
    case _DEF_UART2:
    case _DEF_UART3:
      uart_tbl[ch].qbuffer.in = (uart_tbl[ch].qbuffer.len - ((DMA_Stream_TypeDef *)uart_tbl[ch].p_hdma_rx->Instance)->NDTR);
      ret = qbufferAvailable(&uart_tbl[ch].qbuffer);      
      break;

    case _DEF_UART4:
      ret = cdcAvailable();
      break;      
  }

  return ret;
}

bool uartFlush(uint8_t ch)
{
  uint32_t pre_time;


  pre_time = millis();
  while(uartAvailable(ch))
  {
    if (millis()-pre_time >= 10)
    {
      break;
    }
    uartRead(ch);
  }

  return true;
}

uint8_t uartRead(uint8_t ch)
{
  uint8_t ret = 0;


  switch(ch)
  {
    case _DEF_UART1:
    case _DEF_UART2:
    case _DEF_UART3:
      qbufferRead(&uart_tbl[ch].qbuffer, &ret, 1);
      break;

    case _DEF_UART4:
      ret = cdcRead();
      break;      
  }
  uart_tbl[ch].rx_cnt++;

  return ret;
}

uint32_t uartWrite(uint8_t ch, uint8_t *p_data, uint32_t length)
{
  uint32_t ret = 0;


  switch(ch)
  {
    case _DEF_UART1:
    case _DEF_UART2:
    case _DEF_UART3:
      if (HAL_UART_Transmit(uart_tbl[ch].p_huart, p_data, length, 100) == HAL_OK)
      {
        ret = length;
      }
      break;

    case _DEF_UART4:
      ret = cdcWrite(p_data, length);
      break;      
  }
  uart_tbl[ch].tx_cnt += ret;

  return ret;
}

uint32_t uartPrintf(uint8_t ch, const char *fmt, ...)
{
  char buf[256];
  va_list args;
  int len;
  uint32_t ret;

  va_start(args, fmt);
  len = vsnprintf(buf, 256, fmt, args);

  ret = uartWrite(ch, (uint8_t *)buf, len);

  va_end(args);


  return ret;
}

uint32_t uartGetBaud(uint8_t ch)
{
  uint32_t ret = 0;


  if (ch >= UART_MAX_CH) return 0;

  if (ch == HW_UART_CH_USB)
    ret = cdcGetBaud();
  else
    ret = uart_tbl[ch].baud;
  
  return ret;
}

uint32_t uartGetRxCnt(uint8_t ch)
{
  if (ch >= UART_MAX_CH) return 0;

  return uart_tbl[ch].rx_cnt;
}

uint32_t uartGetTxCnt(uint8_t ch)
{
  if (ch >= UART_MAX_CH) return 0;

  return uart_tbl[ch].tx_cnt;
}

void HAL_UART_MspInit(UART_HandleTypeDef* uartHandle)
{

  GPIO_InitTypeDef GPIO_InitStruct = {0};
  RCC_PeriphCLKInitTypeDef PeriphClkInitStruct = {0};

  
  if(uartHandle->Instance==USART2)
  {
  /** Initializes the peripherals clock
  */
    PeriphClkInitStruct.PeriphClockSelection = RCC_PERIPHCLK_USART2;
    PeriphClkInitStruct.Usart234578ClockSelection = RCC_USART234578CLKSOURCE_D2PCLK1;
    if (HAL_RCCEx_PeriphCLKConfig(&PeriphClkInitStruct) != HAL_OK)
    {
      Error_Handler();
    }

    /* USART2 clock enable */
    __HAL_RCC_USART2_CLK_ENABLE();

    __HAL_RCC_GPIOA_CLK_ENABLE();
    /**USART2 GPIO Configuration
    PA2     ------> USART2_TX
    PA3     ------> USART2_RX
    */
    GPIO_InitStruct.Pin = GPIO_PIN_2|GPIO_PIN_3;
    GPIO_InitStruct.Mode = GPIO_MODE_AF_PP;
    GPIO_InitStruct.Pull = GPIO_NOPULL;
    GPIO_InitStruct.Speed = GPIO_SPEED_FREQ_LOW;
    GPIO_InitStruct.Alternate = GPIO_AF7_USART2;
    HAL_GPIO_Init(GPIOA, &GPIO_InitStruct);

    /* USART2 DMA Init */
    /* USART2_RX Init */
    hdma_usart2_rx.Instance = DMA1_Stream0;
    hdma_usart2_rx.Init.Request = DMA_REQUEST_USART2_RX;
    hdma_usart2_rx.Init.Direction = DMA_PERIPH_TO_MEMORY;
    hdma_usart2_rx.Init.PeriphInc = DMA_PINC_DISABLE;
    hdma_usart2_rx.Init.MemInc = DMA_MINC_ENABLE;
    hdma_usart2_rx.Init.PeriphDataAlignment = DMA_PDATAALIGN_BYTE;
    hdma_usart2_rx.Init.MemDataAlignment = DMA_MDATAALIGN_BYTE;
    hdma_usart2_rx.Init.Mode = DMA_CIRCULAR;
    hdma_usart2_rx.Init.Priority = DMA_PRIORITY_LOW;
    hdma_usart2_rx.Init.FIFOMode = DMA_FIFOMODE_DISABLE;
    if (HAL_DMA_Init(&hdma_usart2_rx) != HAL_OK)
    {
      Error_Handler();
    }

    __HAL_LINKDMA(uartHandle,hdmarx,hdma_usart2_rx);
  }

  if(uartHandle->Instance==USART1)
  {
  /** Initializes the peripherals clock
  */
    PeriphClkInitStruct.PeriphClockSelection = RCC_PERIPHCLK_USART1;
    PeriphClkInitStruct.Usart16ClockSelection = RCC_USART16910CLKSOURCE_D2PCLK2;
    if (HAL_RCCEx_PeriphCLKConfig(&PeriphClkInitStruct) != HAL_OK)
    {
      Error_Handler();
    }

    /* USART1 clock enable */
    __HAL_RCC_USART1_CLK_ENABLE();

    __HAL_RCC_GPIOB_CLK_ENABLE();
    /**USART1 GPIO Configuration
    PB14     ------> USART1_TX
    PB15     ------> USART1_RX
    */
    GPIO_InitStruct.Pin = GPIO_PIN_14|GPIO_PIN_15;
    GPIO_InitStruct.Mode = GPIO_MODE_AF_PP;
    GPIO_InitStruct.Pull = GPIO_NOPULL;
    GPIO_InitStruct.Speed = GPIO_SPEED_FREQ_HIGH;
    GPIO_InitStruct.Alternate = GPIO_AF4_USART1;
    HAL_GPIO_Init(GPIOB, &GPIO_InitStruct);

    /* USART1 DMA Init */
    /* USART1_RX Init */
    hdma_usart1_rx.Instance = DMA1_Stream1;
    hdma_usart1_rx.Init.Request = DMA_REQUEST_USART1_RX;
    hdma_usart1_rx.Init.Direction = DMA_PERIPH_TO_MEMORY;
    hdma_usart1_rx.Init.PeriphInc = DMA_PINC_DISABLE;
    hdma_usart1_rx.Init.MemInc = DMA_MINC_ENABLE;
    hdma_usart1_rx.Init.PeriphDataAlignment = DMA_PDATAALIGN_BYTE;
    hdma_usart1_rx.Init.MemDataAlignment = DMA_MDATAALIGN_BYTE;
    hdma_usart1_rx.Init.Mode = DMA_CIRCULAR;
    hdma_usart1_rx.Init.Priority = DMA_PRIORITY_LOW;
    hdma_usart1_rx.Init.FIFOMode = DMA_FIFOMODE_DISABLE;
    if (HAL_DMA_Init(&hdma_usart1_rx) != HAL_OK)
    {
      Error_Handler();
    }

    __HAL_LINKDMA(uartHandle,hdmarx,hdma_usart1_rx);
  }

  if(uartHandle->Instance==USART3)
  {
  /** Initializes the peripherals clock
  */
    PeriphClkInitStruct.PeriphClockSelection = RCC_PERIPHCLK_USART3;
    PeriphClkInitStruct.Usart234578ClockSelection = RCC_USART234578CLKSOURCE_D2PCLK1;
    if (HAL_RCCEx_PeriphCLKConfig(&PeriphClkInitStruct) != HAL_OK)
    {
      Error_Handler();
    }

    /* USART3 clock enable */
    __HAL_RCC_USART3_CLK_ENABLE();

    __HAL_RCC_GPIOB_CLK_ENABLE();
    __HAL_RCC_GPIOD_CLK_ENABLE();
    /**USART3 GPIO Configuration
    PB10     ------> USART3_TX
    PB11     ------> USART3_RX
    PD12     ------> USART3_DE
    */
    GPIO_InitStruct.Pin = GPIO_PIN_10|GPIO_PIN_11;
    GPIO_InitStruct.Mode = GPIO_MODE_AF_PP;
    GPIO_InitStruct.Pull = GPIO_NOPULL;
    GPIO_InitStruct.Speed = GPIO_SPEED_FREQ_HIGH;
    GPIO_InitStruct.Alternate = GPIO_AF7_USART3;
    HAL_GPIO_Init(GPIOB, &GPIO_InitStruct);

    GPIO_InitStruct.Pin = GPIO_PIN_12;
    GPIO_InitStruct.Mode = GPIO_MODE_AF_PP;
    GPIO_InitStruct.Pull = GPIO_NOPULL;
    GPIO_InitStruct.Speed = GPIO_SPEED_FREQ_HIGH;
    GPIO_InitStruct.Alternate = GPIO_AF7_USART3;
    HAL_GPIO_Init(GPIOD, &GPIO_InitStruct);

    /* USART3 DMA Init */
    /* USART3_RX Init */
    hdma_usart3_rx.Instance = DMA1_Stream2;
    hdma_usart3_rx.Init.Request = DMA_REQUEST_USART3_RX;
    hdma_usart3_rx.Init.Direction = DMA_PERIPH_TO_MEMORY;
    hdma_usart3_rx.Init.PeriphInc = DMA_PINC_DISABLE;
    hdma_usart3_rx.Init.MemInc = DMA_MINC_ENABLE;
    hdma_usart3_rx.Init.PeriphDataAlignment = DMA_PDATAALIGN_BYTE;
    hdma_usart3_rx.Init.MemDataAlignment = DMA_MDATAALIGN_BYTE;
    hdma_usart3_rx.Init.Mode = DMA_CIRCULAR;
    hdma_usart3_rx.Init.Priority = DMA_PRIORITY_LOW;
    hdma_usart3_rx.Init.FIFOMode = DMA_FIFOMODE_DISABLE;
    if (HAL_DMA_Init(&hdma_usart3_rx) != HAL_OK)
    {
      Error_Handler();
    }

    __HAL_LINKDMA(uartHandle,hdmarx,hdma_usart3_rx);
  }

}

void HAL_UART_MspDeInit(UART_HandleTypeDef* uartHandle)
{

  if(uartHandle->Instance == USART2)
  {
    /* Peripheral clock disable */
    __HAL_RCC_USART2_CLK_DISABLE();

    /**USART2 GPIO Configuration
    PA2     ------> USART2_TX
    PA3     ------> USART2_RX
    */
    HAL_GPIO_DeInit(GPIOA, GPIO_PIN_2|GPIO_PIN_3);

    /* USART2 DMA DeInit */
    HAL_DMA_DeInit(uartHandle->hdmarx);
  }

  if(uartHandle->Instance==USART1)
  {
    /* Peripheral clock disable */
    __HAL_RCC_USART1_CLK_DISABLE();

    /**USART1 GPIO Configuration
    PB14     ------> USART1_TX
    PB15     ------> USART1_RX
    */
    HAL_GPIO_DeInit(GPIOB, GPIO_PIN_14|GPIO_PIN_15);

    /* USART1 DMA DeInit */
    HAL_DMA_DeInit(uartHandle->hdmarx);
  }

  if(uartHandle->Instance==USART3)
  {
    /* Peripheral clock disable */
    __HAL_RCC_USART3_CLK_DISABLE();

    /**USART3 GPIO Configuration
    PB10     ------> USART3_TX
    PB11     ------> USART3_RX
    PD12     ------> USART3_DE
    */
    HAL_GPIO_DeInit(GPIOB, GPIO_PIN_10|GPIO_PIN_11);

    HAL_GPIO_DeInit(GPIOD, GPIO_PIN_12);

    /* USART3 DMA DeInit */
    HAL_DMA_DeInit(uartHandle->hdmarx);
  }  
}

#ifdef _USE_HW_CLI
void cliUart(cli_args_t *args)
{
  bool ret = false;


  if (args->argc == 1 && args->isStr(0, "info"))
  {
    for (int i=0; i<UART_MAX_CH; i++)
    {
      cliPrintf("_DEF_UART%d : %s, %d bps\n", i+1, uart_hw_tbl[i].p_msg, uartGetBaud(i));
    }
    ret = true;
  }

  if (args->argc == 2 && args->isStr(0, "test"))
  {
    uint8_t uart_ch;

    uart_ch = constrain(args->getData(1), 1, UART_MAX_CH) - 1;

    if (uart_ch != cliGetPort())
    {
      uint8_t rx_data;

      while(1)
      {
        if (uartAvailable(uart_ch) > 0)
        {
          rx_data = uartRead(uart_ch);
          cliPrintf("<- _DEF_UART%d RX : 0x%X\n", uart_ch + 1, rx_data);
        }

        if (cliAvailable() > 0)
        {
          rx_data = cliRead();
          if (rx_data == 'q')
          {
            break;
          }
          else
          {
            uartWrite(uart_ch, &rx_data, 1);
            cliPrintf("-> _DEF_UART%d TX : 0x%X\n", uart_ch + 1, rx_data);            
          }
        }
      }
    }
    else
    {
      cliPrintf("This is cliPort\n");
    }
    ret = true;
  }

  if (ret == false)
  {
    cliPrintf("uart info\n");
    cliPrintf("uart test ch[1~%d]\n", HW_UART_MAX_CH);
  }
}
#endif


#endif
