chcbaram/wiznet-iot-speaker/firmware/wiznet-iot-speaker-boot/src/hw/driver/button.c

#include "button.h"
#include "cli.h"


#ifdef _USE_HW_BUTTON


typedef struct
{
  GPIO_TypeDef *port;
  uint32_t      pin;
  GPIO_PinState on_state;
} button_tbl_t;


button_tbl_t button_tbl[BUTTON_MAX_CH] =
    {
        {GPIOG, GPIO_PIN_4, GPIO_PIN_RESET},
        {GPIOG, GPIO_PIN_3, GPIO_PIN_RESET},
        {GPIOG, GPIO_PIN_2, GPIO_PIN_RESET},
        {GPIOG, GPIO_PIN_0, GPIO_PIN_RESET},  // I/O Encoder Left 
        {GPIOG, GPIO_PIN_1, GPIO_PIN_RESET},  // I/O Encoder Right
    };


#ifdef _USE_HW_CLI
static void cliButton(cli_args_t *args);
#endif


bool buttonInit(void)
{
  bool ret = true;
  GPIO_InitTypeDef GPIO_InitStruct = {0};


  __HAL_RCC_GPIOG_CLK_ENABLE();


  GPIO_InitStruct.Mode = GPIO_MODE_INPUT;
  GPIO_InitStruct.Pull = GPIO_PULLUP;

  for (int i=0; i<BUTTON_MAX_CH; i++)
  {
    GPIO_InitStruct.Pin = button_tbl[i].pin;
    HAL_GPIO_Init(button_tbl[i].port, &GPIO_InitStruct);
  }

#ifdef _USE_HW_CLI
  cliAdd("button", cliButton);
#endif

  return ret;
}

bool buttonGetPressed(uint8_t ch)
{
  bool ret = false;

  if (ch >= BUTTON_MAX_CH)
  {
    return false;
  }

  if (HAL_GPIO_ReadPin(button_tbl[ch].port, button_tbl[ch].pin) == button_tbl[ch].on_state)
  {
    ret = true;
  }

  return ret;
}

uint32_t buttonGetData(void)
{
  uint32_t ret = 0;


  for (int i=0; i<BUTTON_MAX_CH; i++)
  {
    ret |= (buttonGetPressed(i)<<i);
  }

  return ret;
}


#ifdef _USE_HW_CLI

void cliButton(cli_args_t *args)
{
  bool ret = false;


  if (args->argc == 1 && args->isStr(0, "show"))
  {
    while(cliKeepLoop())
    {
      for (int i=0; i<BUTTON_MAX_CH; i++)
      {
        cliPrintf("%d", buttonGetPressed(i));
      }
      cliPrintf("\n");

      delay(100);
    }

    ret = true;
  }


  if (ret != true)
  {
    cliPrintf("button show\n");
  }
}
#endif



#endif
