chcbaram/wiznet-iot-speaker/(commit log)

2023-04-17 ioc 파일 추가
2023-04-22 ioc 업데이트
2023-04-29 Added Hardware files.
    [BOM_PCB_IOT-SPEAKER-IO_2023-04-30.csv, BOM_PCB_IOT-SPEAKER_2023-04-30.csv, PickAndPlace_PCB_IOT-SPEAKER-IO_2023-04-30.csv, PickAndPlace_PCB_IOT-SPEAKER_2023-04-30.csv]
2023-05-01 펌웨어 초기 프로젝트 추가
2023-05-04 LED/UART 추가
2023-05-04 FMC 추가
2023-05-04 Buzzer 추가
2023-05-04 GPIO 추가
2023-05-04 수정된 IO 보드 PCB 파일 추가
    [PickAndPlace_PCB_IOT-SPEAKER-IO_2023-05-05.csv]
2023-05-04 W5300 작업 중
2023-05-05 W5300 초기화 구현중
2023-05-05 W5300 UDP 시험중
2023-05-08 하드폴트 처리 추가
2023-05-08 FLASH 코드 수정
2023-05-08 QSPI 작업중
2023-05-08 QSPI FLASH 구현 완료
2023-05-08 부팅 로그 수정
2023-05-09 FLASH CLI 코드 정리
2023-05-13 LittleFS 추가
2023-05-13 UART Debug 채널 추가
2023-05-13 로그 UART 오픈 오류 수정
    [hw.c]
2023-05-13 DXL 포트 추가
2023-05-13 SD CARD 추가
2023-05-13 FatFs 추가
2023-05-13 I2C 추가
2023-05-13 I2S 추가
2023-05-13 I2S 수정
2023-05-13 I2S 채널 업데이트
2023-05-14 I2S 코드 정리
2023-05-14 SAI, ES8156 추가
2023-05-14 확장 IO 보드 엔코더 버튼 추가
2023-05-14 확장 IO 엔코더 신호 GPIO에 추가
2023-05-15 로터리 엔코더 추가
2023-05-16 LCD 작업 중
2023-05-17 LCD 작업 완료
2023-05-17 LCD 예제 수정
2023-05-17 LCD 코드 정리
2023-05-17 LCD 회전 추가
2023-05-18 LCD PWM, NVS 모듈 추가
2023-05-18 코드 정리
2023-05-18 LCD 파라메터 파일명 변경
2023-05-24 Mixer 추가
2023-05-24 USB CDC 추가
2023-05-24 USB 코드 정리
2023-05-24 USB 연결 코드 수정.
2023-05-25 RTC, RESET 기능 추가
    [hw.c, hw.h, hw_def.h, rtc.c]
2023-05-26 FFT 추가
2023-06-03 다운로드 프로그램 추가
2023-06-03 qspi erase 버그 수정
    [ap.cpp, hw.c, qspi.c]
2023-06-03 부트로더 구현
2023-06-04 다운로더 도움말 수정
2023-06-04 UDP 다운로드 추가
2023-06-05 udp ip 설정 오류 수정
2023-06-05 다운로드 프로그램 설명 수정
    [ap.cpp]
2023-06-05 다운로드 정보 LCD에 표시
2023-06-07 부트로더 추가 명령어 구현
2023-06-09 DHCP 구현중..
2023-06-10 DHCP 구현 추가
2023-06-10 DHCP 별도 실행으로 변경함
2023-06-10 wiznet cli 추가
2023-06-10 DHCP 결과 LCD 표시
2023-06-10 SNTP 추가
2023-06-10 소켓 번호 이름 변경
2023-06-10 UDP 브로드캐스트 업데이트 추가
2023-06-10 CMD 드라이버 수정
2023-06-12 AUDIO 스트리밍 추가
2023-06-12 오디오 파일 제거
2023-06-13 WAV 오디오 스트림 추가
2023-06-13 LCD 출력 조건 변경
2023-06-15 pySide6 프로젝트 추가
2023-06-15 UI 폰트 사이즈 변경
2023-06-16 둥근모 글꼴 추가
2023-06-16 macOS에서 pyside6 폰트 추가 수정
2023-06-16 loader 윈도우용 변경
2023-06-16 loader 오디오 파일 처리 방식 변경
2023-06-16 오디오 스트리밍시 샘플레이트 변경 추가
2023-06-16 빌드 경고 제거
2023-06-16 맥용 loader 업데이트
2023-06-18 OSD 볼륨 추가
2023-06-18 오디오 스트리밍 LCD 출력 주기 변경
2023-06-22 MQTT 파일 추가
2023-06-24 오디오 스트리밍 버퍼 처리 방식 변경
2023-07-04 GUI 구현 중
2023-07-04 스레드 수신 처리 변경
2023-07-09 GUI 편집 중
2023-07-09 GUI 작업 중
2023-07-09 GUI 초기버전 완성
2023-07-09 GUI 설명 문서 추가
2023-07-09 README 수정
2023-07-09 통신 버퍼 크기 조정
2023-07-09 통신 버퍼 조정
2023-07-09 wav 파일 버퍼링으로 변경
2023-07-09 wav 파일 읽기 버전으로 변경
2023-09-07 LCD SPI 타이밍 문제 수정
    [hw_def.h, st7789.c]
2023-09-13 USB 오디오 스트리밍 추가
2023-09-13 경고 제거
