chcbaram/wiznet-iot-speaker/(notices)

Notices in the files:
firmware/stm32cube/Core/Inc/main.h:
Copyright (c) 2023 STMicroelectronics.
All rights reserved.
This software is licensed under terms that can be found in the LICENSE file
firmware/wiznet-iot-speaker-fw/src/hw/driver/wiznet/w5300.h:
Copyright (c) 2015, WIZnet Co., LTD.
